Sim-59/ATtiny-DCC-Signal-Decoder/images/ezmg_komplett_03.jpg

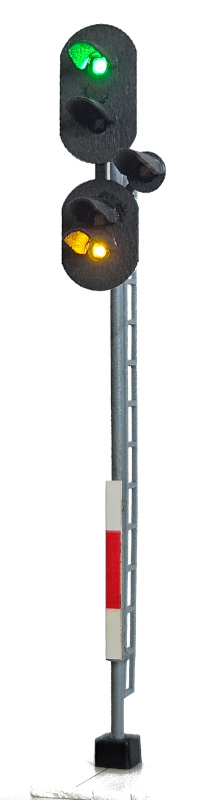
images/ezmg_komplett_03.jpg
