Sim-59/ATtiny-DCC-Signal-Decoder/images/PCB_MuFuDec_01.png

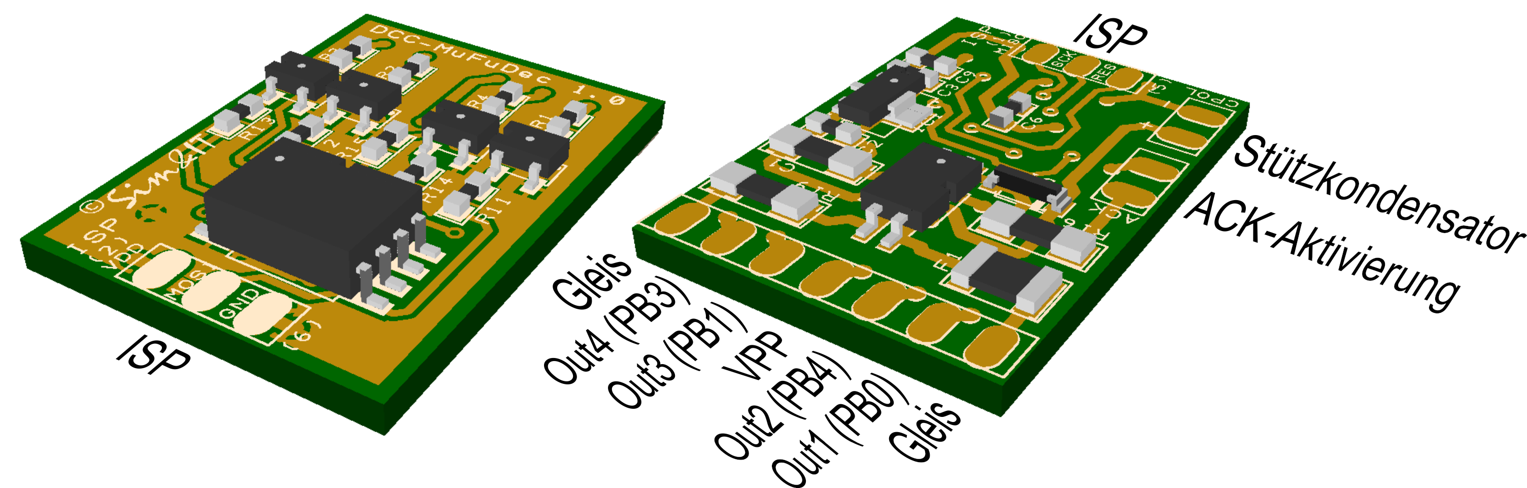
images/PCB_MuFuDec_01.png
