Sim-59/ATtiny-DCC-Signal-Decoder/(commit log)

2026-05-27 Update README with ATtiny85 programming details
    Added additional information about the ATtiny85 programming and clarified the second PCB variant for the DCC decoder.
2026-05-27 Revise signal terms for 4 LEDs on side track
    Updated signal terms for side track with LEDs.
2026-05-28 Update Readme.md for clarity and remove duplicates
    Removed duplicate information about programming the ATtiny85 and updated the description of the additional circuit board.
2026-06-02 Update Readme with SoftDim brightness configuration
    Added SoftDim brightness control details for three ports with PWM.
2026-06-11 Fix typo in DCC decoder board description
2026-06-11 Clarify second PCB variant details in Readme
    Updated description of the second PCB variant for the DCC decoder to include voltage supply details.
2026-10-11 Add files via upload
    10.10.2026
    Dim-Version 52
    CV34 Blinkperiode auf 1,3 s default
    Entfernen des Blink-Codes für Rot, Grün, Gelb-unten
    Verschieben startBlinkMillis() in Run_HL_ASPECT
2026-10-11 Add files via upload
    CV34 Blinkperiode auf 1,3 s default (46/min)
    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
2026-10-30 Update description of PCB variant for DCC decoder
2026-10-30 Fix link formatting in Readme.md
    Removed an extra closing parenthesis in the link for the current PCB variant.
2026-10-30 Clarify decoder functionality and PWM dimming
    Updated the Readme to clarify the decoder's functionality and PWM dimming features.
2026-11-03 Add PCB image to README
    Added an image to the README for better visualization.
2026-11-04 Clarify hardware setup and programming info in Readme
    Updated the description of the hardware setup for the DCC decoder, clarifying the use of the additional board and programming information.
